mauricioplopes/water-tank-monitor/pictures/image_13.png

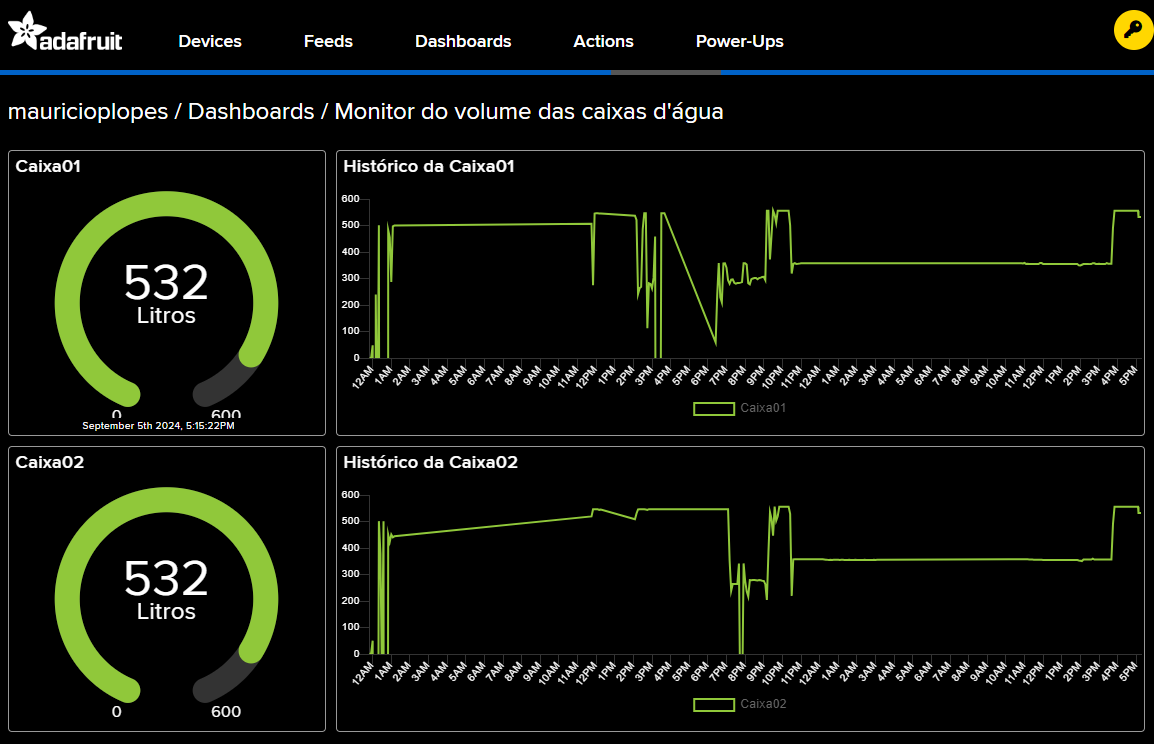
pictures/image_13.png
